Coen-Lab/hw-behaviour-box/Assembly/Parts/LidAndSpacer.stl

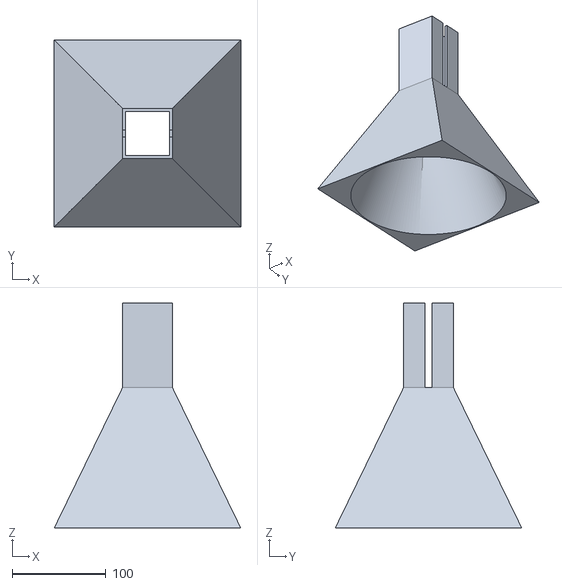
[picture p1: CAD file, 2026-10-27]
Assembly/Parts/LidAndSpacer.stl
199.0 x 199.0 x 240.0
