Coen-Lab/hw-behaviour-box/(commit log)

2026-10-22 Record video with FFmpeg on Quick Sync, track by centre of mass
    Bonsai.Vision's VideoWriter encodes FMP4 on one thread inside Bonsai. On the
    N150 it fell behind at 1440 x 1080, 50 Hz whenever the CPU was busy, the
    unwritten frames queued in RAM, and a 30-min session crashed at ~23 min.
    Bonsai.FFmpeg's VideoWriter pipes raw frames to ffmpeg.exe, which encodes
    H.264 on Intel Quick Sync: with one core kept busy the old writer grew ~1 GB
    a minute while this one stayed flat with every frame written.
    - Tracking is now Threshold then Centroid (centre of mass of all dark
    pixels); the region nodes are gone, which also saves CPU.
    - Preview windows sit on two 5 Hz SampleInterval nodes, not the write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
2026-10-27 Re-export LidAndSpacer.stl from Complete_Package v24
2026-10-28 Fix the crashes that needed a Bonsai restart, and frame pairing
    - Camera: replace the UclOpen.Devices:TriggeredSpinnaker.bonsai include
    with an inline group. FrameID and Timestamp are copied inside the
    camera callback; reading Spinnaker chunk data after the image was
    released crashed Bonsai on the 2nd+ Start.
    - Pairing: the camera takes the trigger events as input (UclOpen
    TriggeredSpinnaker.Generate<TPayload>, FrameID gaps filled before
    pairing), only Harp Event messages count as triggers, and
    StartCameras waits 5 s so the camera is armed first. A dropped frame
    no longer shifts later Seconds, and the first row is no longer early.
    The CSV ExposureTime column is now the config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
2026-10-28 Stop on missing camera frames, ship UclOpen.Video as its own version
    From an independent audit of the previous commit.
    - Workflow: a Timeout (15 s) after the camera stops the run with
    "The operation has timed out." when no frame arrives, so a camera
    that gets no trigger pulses (the trigger cable, as on 23-26 Oct) no
    longer runs for the whole trial and writes nothing. It does not fire
    after the trial ends: the Harp keeps triggering until Stop.
    - UclOpen.Video 0.0.0-sandbox-fullframe: the full-frame DLL had been
    swapped into 0.0.0-sandbox, which a restore never replaces on a
    machine that already has it, so existing installs kept the old DLL.
    Nuspec now cites the commit it was bu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
2026-10-28 Troubleshooting: the CORMEM.SYS dialog at camera start
    Spinnaker's GigE search loads Teledyne's memory library, which needs a
    driver only Sapera LT installs; the camera is USB3, so switch the search
    off with SystemNodeConfig. Undo by deleting the two .ini files (the
    "true" command fails). rig-setup's Rig_Behaviour-Box profile already
    does this (genTLSearch row).
